WaseemALTamer/FMRadioUniversity/Dump/__Notes__.md

this contain useless files that helped me understand librries modules and so far
if you dont see code to do with other modules that  means that those modules are
simple enough to understand or have a straight forward library.
