WaseemALTamer/FMRadioUniversity/documentation/Code/design_decisions.docx

This page should not be included in the report, this is a message to the person compiling for the final report submission.

This file is decisions we made along the way when making the project, this includes decisions that did go through and ones that didn’t go through.

Design Decisions

Modular design

Before we started the project we discussed about how the project should be build and we all come to a conclusion of making each module very easily disabled, this is because we anted to make it easier for our self when modules did clash together as we added them later on this allowed us to test each module separately as we build Veroboard and PCB later on down the line, this also came in handy when measuring the time that it takes to talk over the I2C modules and how that time effects the ultrasound module as it is a time sensitive module.

Saving a GPIO pin

During the process of discussing what modules to have, we found out that we will be 1 GPIO pin short to fit all the modules that we had planned, so we started looking into which modules uses which pins and we found that the RTC clock module contain a INT pin used to tell the Arduino about the alarm, we noticed that we can leave the pin unconnected to the Arduino and since we can still communicate to the RTC clock pin through the I2C pin and ask it for the alarm time that we sad we can simply just check the alarm time internally every second and when we reach the alarm time we simply trigger the same event that the INT pin was triggering, saving this pin allowed us to add the infrared sensor.

Adding a game

After we managed to complete what we aimed for we made a simple game with our simple code architecture, the game idea is straightforward, have a right pointing arrow that you can move around the lcd which avoid the obstacles that move from right to left and the more you avoid the higher your score will be, while this game was doable we still decided against it the reason is because the SRAM was already 70% filled and filling it more was going to risk making the Arduino nano freeze due to not enough ram for the stack.

Making the event system

Before we started the project we was discussing about using interrupts or polling system, at the end of our discussion we agreed for a polling system and the reason the Arduino nano only had 2 interrupts and we wanted to add as many modules as possible, we also wanted to make the project architecture the same everywhere so we decided to build everything with polling system hooked up to an event system, and if we encounter a module that is time sensitive we can use interrupts for it which also operates on the same event system.

Pages system

After discussing what features we wanted to have in our project we noticed the features lay on 3 categories, features that control output (FM module control), features that only tell you about your surroundings like humidity or temperature, and a feature like time that only keeps track of time and displays it on the lcd, for all these features we wanted to display them on screen they all sure almost the exact same idea of being able to change them on the go for example change the volume for FM radio chip you want to change the current time, or the alarm and so on and so forth.

The problem right here was not really making the page system but rather memory management because while we can make a page for each feature that we wanted to control or display we couldn’t afford to make each page logic different from one another and where each have there own editing system because simply adding a single page it approximates about 34 bytes, and adding there own editing logic will consume another 34 bytes this adds up if you want to make 8-9 pages like we did, so we decided to go with a page for each feature and a editing logic that works on all pages this way we only end up using about 306 bytes for all the pages and another 34 bytes for the logic only which is a lot more affordable and at that time we sat at 70% memory usage after adding all the pages.

We also came to conclusion to make the page system a linked list such that each page points to the next page and the previous page, this made the navigation system a lot simple to make, this also allowed us to integrate popup pages clearly, for example the popup page for the alarm where we made popup pages appear and get linked to the page that you were last on.

LCD Scheduler system

we foresaw and problem that we could encounter where after connecting the lcd if the lcd where to be updated too fast this will cause the lcd to flicker as internally the lcd itself takes time to update the screen, we also didn’t want to update the screen when nothing on screen changed, this gave a birth the LCD scheduler system which you can update by your self rather you schedule and update to happen and the system will do it whenever it can if you try to update the lcd before it flashes itself your latest over update will be the only one that getting flashed, this helped eliminate flickering it also helped the updating the lcd not happen every update as a result other modules that are time sensitive like the ultrasound sensor had more accurate readings and over all more accurate distance measurements.

Separation of concern

Structuring our code was a big part of how we worked as a team, and before we started writing the system we laid out the structure so everybody understands it and can expand on the system while staying in line, our there is 3 different type of files, first the base layer component files which are simply the modules names, such as buttons, encoder and so on and so forth, those modules are responsible for passing the events forward to the next layer of the code, then comes the intermediate layer which consists of the whole system, which the naming goes like this “page_manager” which is responsible for handling all the different pages along with their universal edit logic, then we have the actual pages we name them as “page_*” and each page inherit the edit system, but it doesn’t inherit the apply function after editing the system so it contain the logic that it need to function as expected, for example “page_time”, is the page responsible for displaying the time and editing and setting the current time.

We also have pop up pages which follow the same exact structure as a normal page but they are not included in the linked list and when the page manager sees that they want to display themselves, the manager displays them and links them to the already displayed page at the time, this logic is also shared by all the popups assume that you have a 2 popups and somehow they both want to be displayed then the first one get linked to the page you where already on and the second one will link to the popup page itself.

The “page_*” modules don’t rely on any update logic to update them self, and they are only event driven as a result they are consistent and very predictable this also allows all the pages to stay isolated as they are never run any logic by themselves.

For quick module testing we encouraged the team to leave example files inside the example folder so we can quickly flash the Arduino and check if a specific code is written clearly and pass all the required tests before we integrate it.

We understood that many of us come from completely different backgrounds for coding ability and as result we managed to make all the project self-contain where it holds all the libraries where the specific version for them to work in the same working directory, this allows us to share the full code easily without worrying about dependency installation.

To keep track of the memory usage and which modules take more memory we encouraged the team to leave a memory usage assessment on top of the file so we can further make better decisions as our project evolves.

Code entry point

The entry point of our project marks a big step for our separation of concern for each module and the architecture layers that we build to move forward with, our entry point is the place that lets us disable or enable modules on the go by simply commenting the initiation of each module and also disabling the polling loop for each module, and because the page system simply runs over the events, the pages will still be there but the content will be missing, this also worked to our advantage to quickly assess which modules are working correctly and which modules are not working properly.
