WaseemALTamer/FMRadioUniversity/PCB/Version-1/footprints/TDA2822D/TDA2822D.step

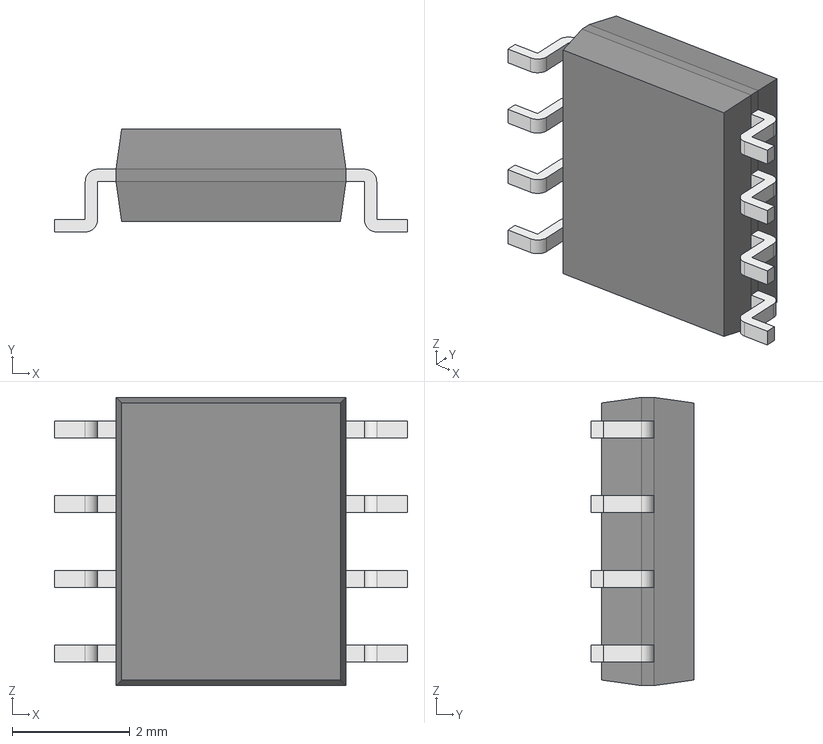
[picture p18: CAD file, 2026-08-18, an earlier design]
PCB/Version-1/footprints/TDA2822D/TDA2822D.step
6.00 x 1.75 x 4.90 mm
Body001 (Mirror #1) x 4
XY-plane x 12
X-axis x 12
