WaseemALTamer/FMRadioUniversity/PCB/Version-2/FMRadio.kicad_pcb

## KiCad design PCB/Version-2/FMRadio.kicad_pcb (2026-08-18)

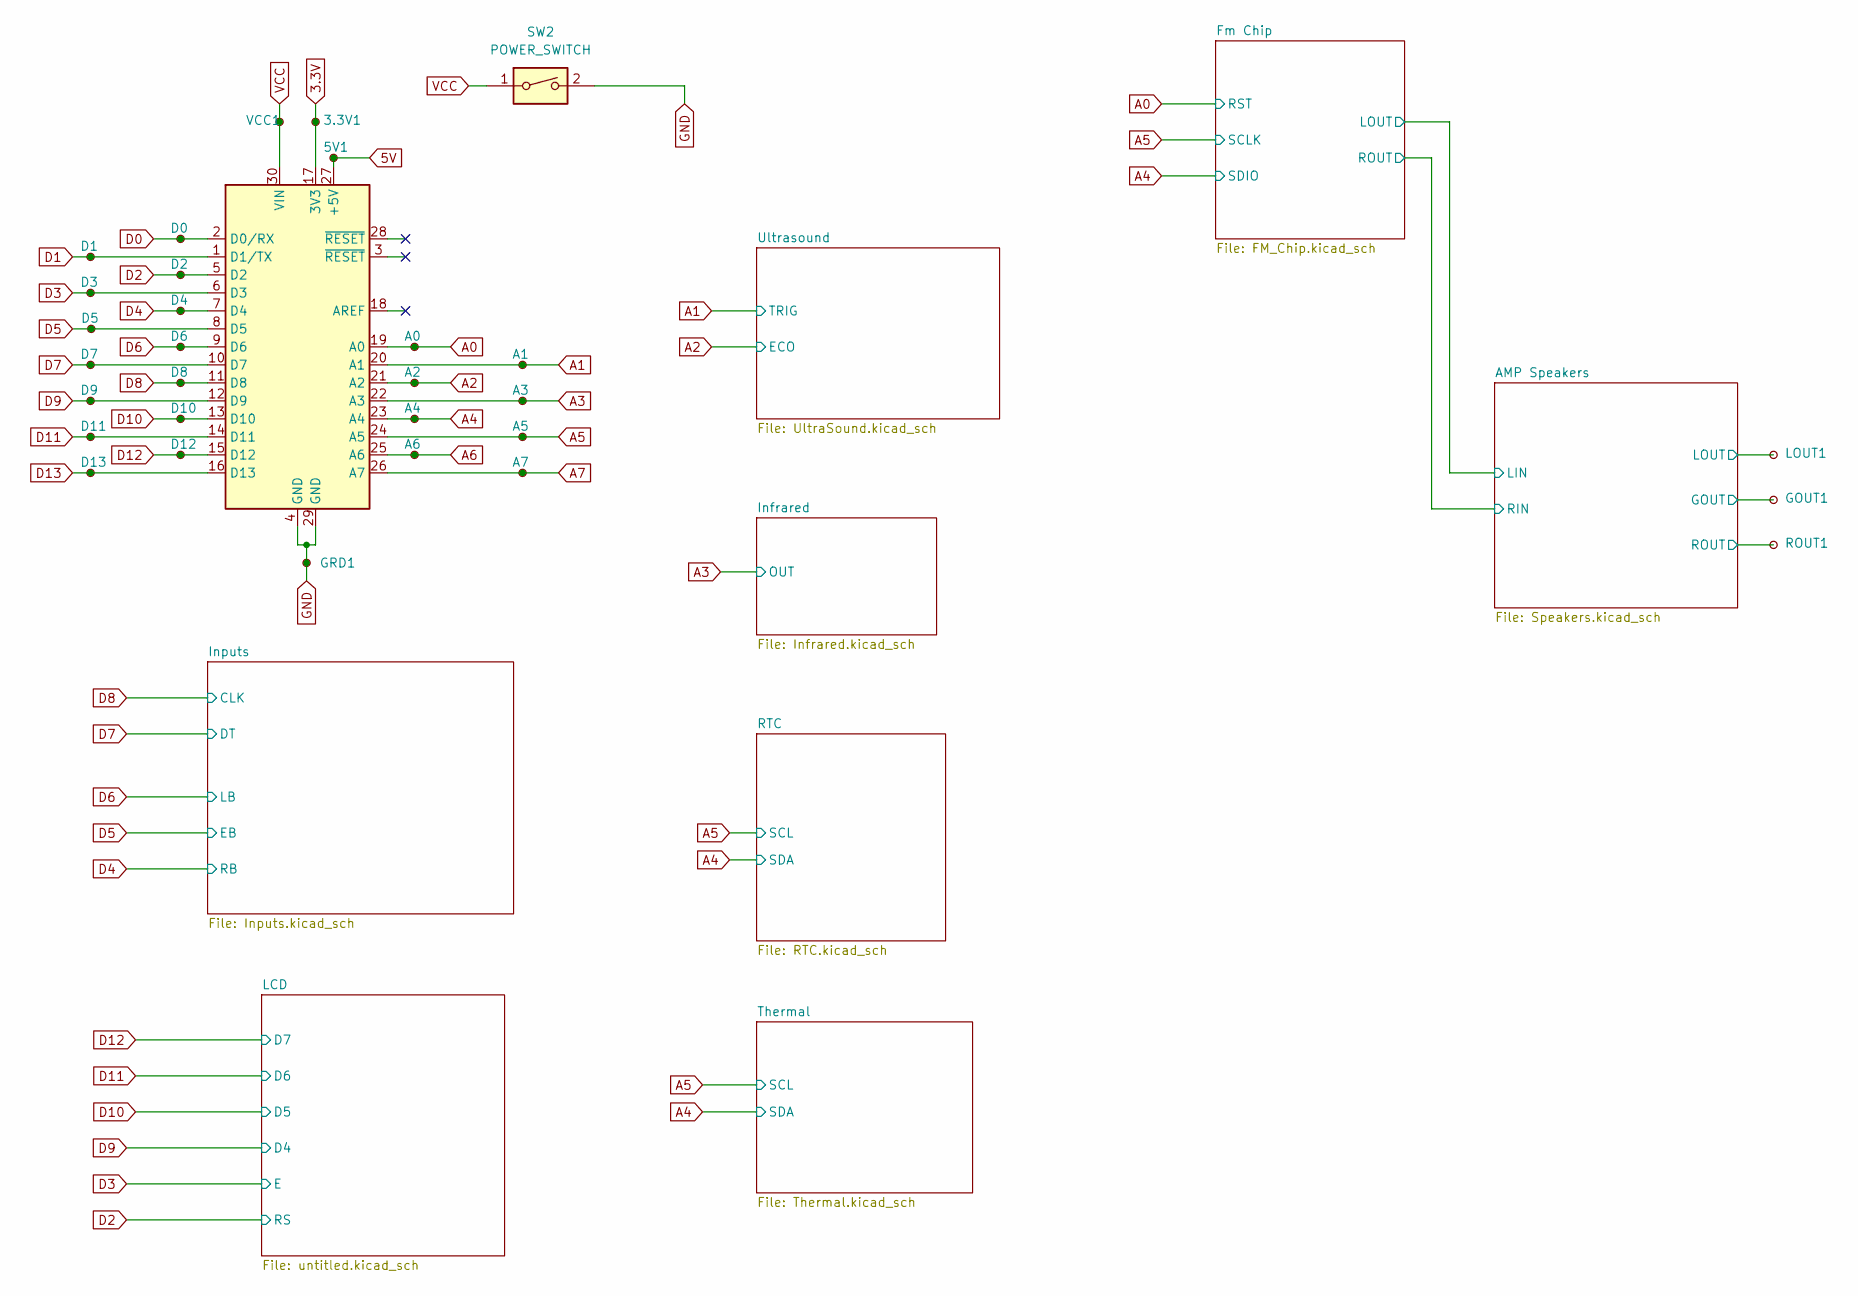
[picture p19: schematic FMRadio.kicad_sch]

Parts:
3.3V1, 5V1: TestPoint_Small; PinHeader_1x04_P2.54mm_Vertical_Custum_shortedpins
A0, A1, A2, A3, A4, A5, A6, A7: TestPoint_Small; PinHeader_1x04_P2.54mm_Vertical_Custum_shortedpins
AN1: Arduino_Nano_v3.x; Arduino_Nano
D0, D1, D2, D3, D4, D5, D6, D7, D8, D9, D10, D11, D12, D13: TestPoint_Small; PinHeader_1x04_P2.54mm_Vertical_Custum_shortedpins
GOUT1: PinHeader_1x04_P2.54mm_Vertical_Custum_shortedpins
GRD1: TestPoint_Small; PinHeader_1x04_P2.54mm_Vertical_Custum_shortedpins
LOUT1: PinHeader_1x04_P2.54mm_Vertical_Custum_shortedpins
ROUT1: PinHeader_1x04_P2.54mm_Vertical_Custum_shortedpins
SW2: POWER_SWITCH; PinHeader_1x02_P2.54mm_Vertical
VCC1: TestPoint_Small; PinHeader_1x04_P2.54mm_Vertical_Custum_shortedpins

Connections:
3.3V: 3.3V1.1, AN1.17 (3V3); also elsewhere on the board
5V: 5V1.1, AN1.27 (+5V); also elsewhere on the board
/AMP Speakers/LOUT: LOUT1.1; also elsewhere on the board
/AMP Speakers/ROUT: ROUT1.1; also elsewhere on the board
A0: A0.1, AN1.19 (A0); also elsewhere on the board
A1: A1.1, AN1.20 (A1); also elsewhere on the board
A2: A2.1, AN1.21 (A2); also elsewhere on the board
A3: A3.1, AN1.22 (A3); also elsewhere on the board
A4: A4.1, AN1.23 (A4); also elsewhere on the board
A5: A5.1, AN1.24 (A5); also elsewhere on the board
A6: A6.1, AN1.25 (A6)
A7: A7.1, AN1.26 (A7)
D0: AN1.2 (D0/RX), D0.1
D1: AN1.1 (D1/TX), D1.1
D2: AN1.5 (D2), D2.1; also elsewhere on the board
D3: AN1.6 (D3), D3.1; also elsewhere on the board
D4: AN1.7 (D4), D4.1; also elsewhere on the board
D5: AN1.8 (D5), D5.1; also elsewhere on the board
D6: AN1.9 (D6), D6.1; also elsewhere on the board
D7: AN1.10 (D7), D7.1; also elsewhere on the board
D8: AN1.11 (D8), D8.1; also elsewhere on the board
D9: AN1.12 (D9), D9.1; also elsewhere on the board
D10: AN1.13 (D10), D10.1; also elsewhere on the board
D11: AN1.14 (D11), D11.1; also elsewhere on the board
D12: AN1.15 (D12), D12.1; also elsewhere on the board
D13: AN1.16 (D13), D13.1
GND: AN1.4 (GND), AN1.29 (GND), GOUT1.1, GRD1.1, SW2.2; also elsewhere on the board
VCC: AN1.30 (VIN), SW2.1, VCC1.1; also elsewhere on the board

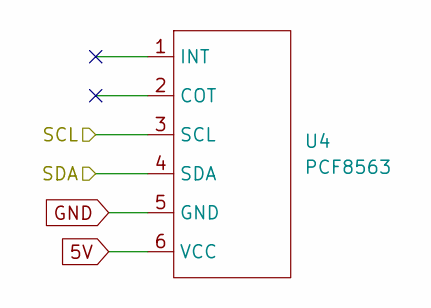
[picture p20: schematic RTC.kicad_sch]

Parts:
U4: PCF8563; PinHeader_1x06_P2.54mm_Vertical

Connections:
5V: U4.6 (VCC); also elsewhere on the board
A4: U4.4 (SDA); also elsewhere on the board
A5: U4.3 (SCL); also elsewhere on the board
GND: U4.5 (GND); also elsewhere on the board

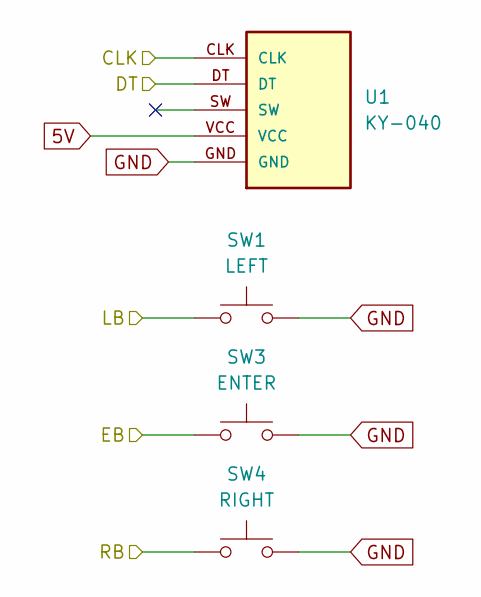
[picture p21: schematic Inputs.kicad_sch]

Parts:
SW1: LEFT; SW_PUSH_6mm_H4.3mm
SW3: ENTER; SW_PUSH_6mm_H4.3mm
SW4: RIGHT; SW_PUSH_6mm_H4.3mm
U1: KY-040; KY-040-PORT

Connections:
5V: U1.VCC; also elsewhere on the board
D4: SW4.1; also elsewhere on the board
D5: SW3.1; also elsewhere on the board
D6: SW1.1; also elsewhere on the board
D7: U1.DT; also elsewhere on the board
D8: U1.CLK; also elsewhere on the board
GND: SW1.2, SW3.2, SW4.2, U1.GND; also elsewhere on the board

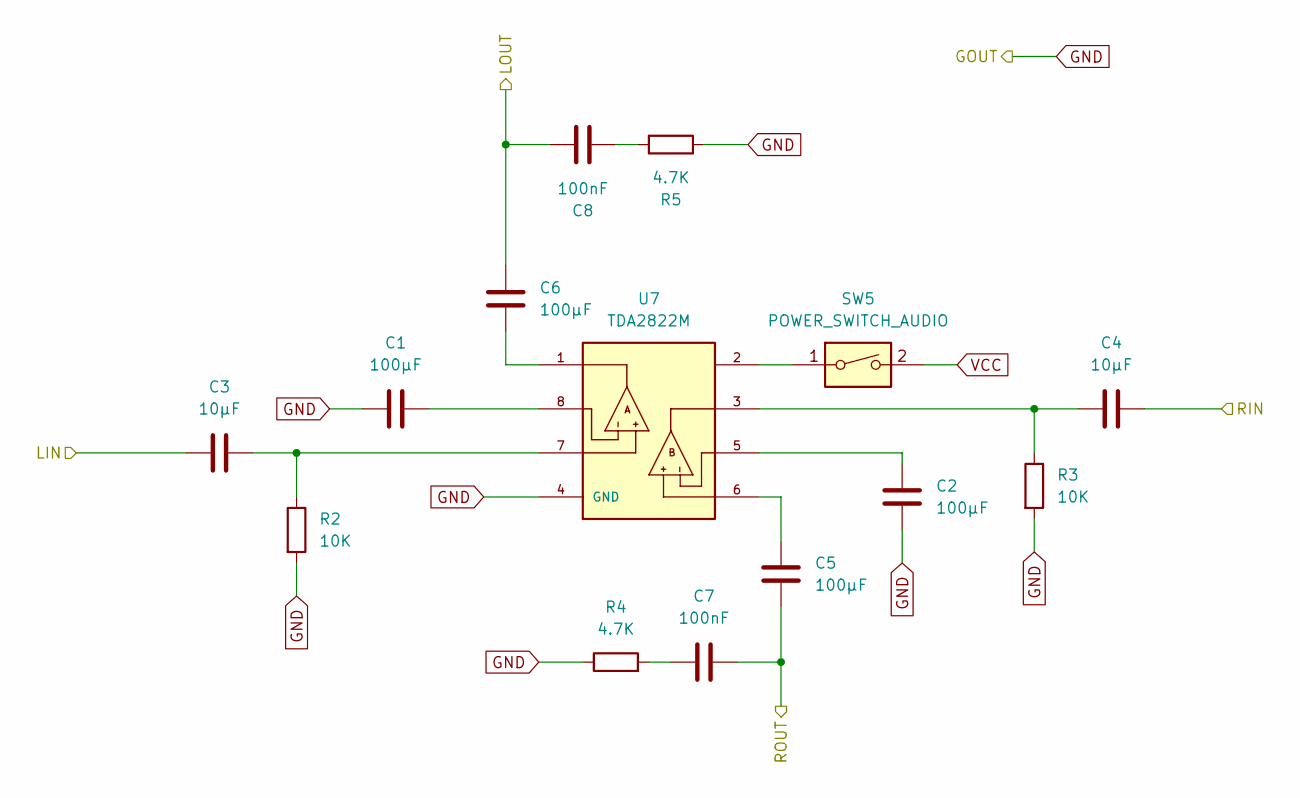
[picture p22: schematic Speakers.kicad_sch]

Parts:
C1, C2, C5, C6: 100μF; CP_Radial_D5.0mm_P2.50mm
C3, C4: 10μF; CP_Radial_D5.0mm_P2.50mm
C7, C8: 100nF; CP_Radial_D5.0mm_P2.50mm
R2, R3: 10K; R_Axial_DIN0207_L6.3mm_D2.5mm_P10.16mm_Horizontal
R4, R5: 4.7K; R_Axial_DIN0207_L6.3mm_D2.5mm_P10.16mm_Horizontal
SW5: POWER_SWITCH_AUDIO; PinHeader_1x02_P2.54mm_Vertical
U7: TDA2822M; DIP762W45P254L1092H508Q8; PARTREV September 2003

Connections:
/AMP Speakers/LIN: C3.1; also elsewhere on the board
/AMP Speakers/LOUT: C6.2, C8.1; also elsewhere on the board
/AMP Speakers/RIN: C4.2; also elsewhere on the board
/AMP Speakers/ROUT: C5.1, C7.1; also elsewhere on the board
GND: C1.1, C2.1, R2.2, R3.2, R4.1, R5.1, U7.4 (GND); also elsewhere on the board
unnamed: C1.2, U7.8
unnamed: C2.2, U7.5
unnamed: C3.2, R2.1, U7.7
unnamed: C4.1, R3.1, U7.3
unnamed: C5.2, U7.6
unnamed: C6.1, U7.1
unnamed: C7.2, R4.2
unnamed: C8.2, R5.2
unnamed: SW5.1, U7.2
VCC: SW5.2; also elsewhere on the board

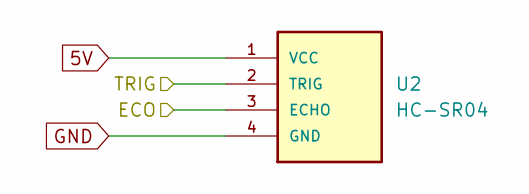
[picture p23: schematic UltraSound.kicad_sch]

Parts:
U2: HC-SR04; XCVR_HC-SR04

Connections:
5V: U2.1 (VCC); also elsewhere on the board
A1: U2.2 (TRIG); also elsewhere on the board
A2: U2.3 (ECHO); also elsewhere on the board
GND: U2.4 (GND); also elsewhere on the board

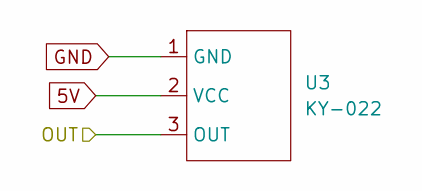
[picture p24: schematic Infrared.kicad_sch]

Parts:
U3: KY-022; PinHeader_1x03_P2.54mm_Vertical

Connections:
5V: U3.2 (VCC); also elsewhere on the board
A3: U3.3 (OUT); also elsewhere on the board
GND: U3.1 (GND); also elsewhere on the board

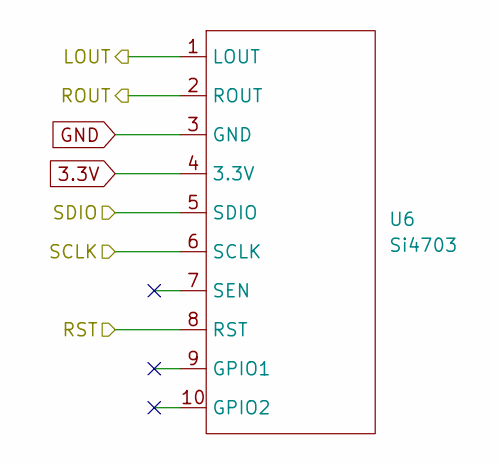
[picture p25: schematic FM_Chip.kicad_sch]

Parts:
U6: Si4703; PinHeader_1x10_P2.54mm_Vertical

Connections:
3.3V: U6.4 (3.3V); also elsewhere on the board
/AMP Speakers/LIN: U6.1 (LOUT); also elsewhere on the board
/AMP Speakers/RIN: U6.2 (ROUT); also elsewhere on the board
A0: U6.8 (RST); also elsewhere on the board
A4: U6.5 (SDIO); also elsewhere on the board
A5: U6.6 (SCLK); also elsewhere on the board
GND: U6.3 (GND); also elsewhere on the board

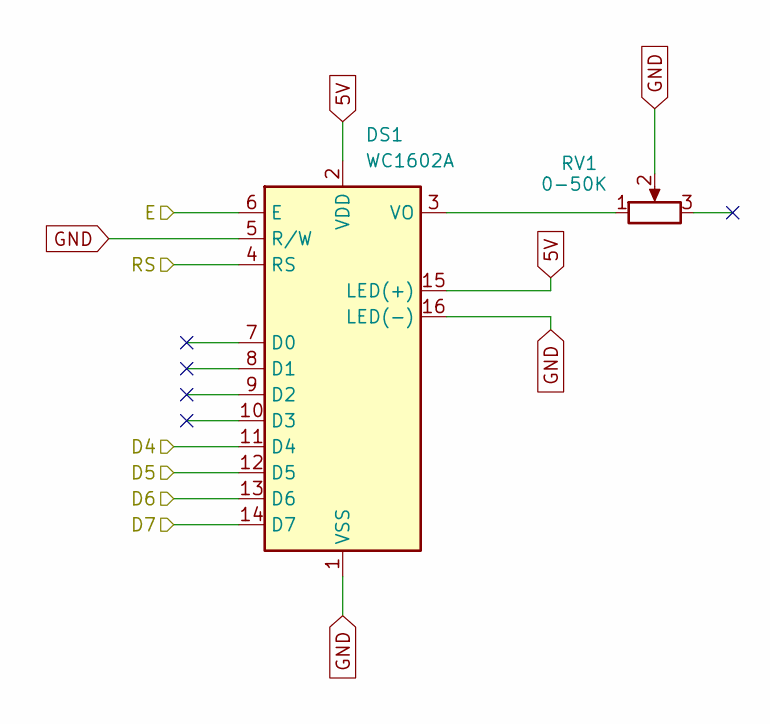
[picture p26: schematic untitled.kicad_sch]

Parts:
DS1: WC1602A
RV1: 0-50K; Potentiometer_Piher_PT-10-V10_Vertical

Connections:
5V: DS1.2 (VDD), DS1.15 (LED(+)); also elsewhere on the board
D2: DS1.4 (RS); also elsewhere on the board
D3: DS1.6 (E); also elsewhere on the board
D9: DS1.11 (D4); also elsewhere on the board
D10: DS1.12 (D5); also elsewhere on the board
D11: DS1.13 (D6); also elsewhere on the board
D12: DS1.14 (D7); also elsewhere on the board
GND: DS1.1 (VSS), DS1.5 (R/W), DS1.16 (LED(-)), RV1.2; also elsewhere on the board
unnamed: DS1.3 (VO), RV1.1

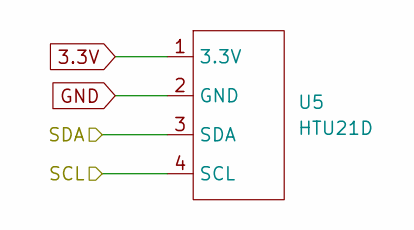
[picture p27: schematic Thermal.kicad_sch]

Parts:
U5: HTU21D; PinHeader_1x04_P2.54mm_Vertical

Connections:
3.3V: U5.1 (3.3V); also elsewhere on the board
A4: U5.3 (SDA); also elsewhere on the board
A5: U5.4 (SCL); also elsewhere on the board
GND: U5.2 (GND); also elsewhere on the board

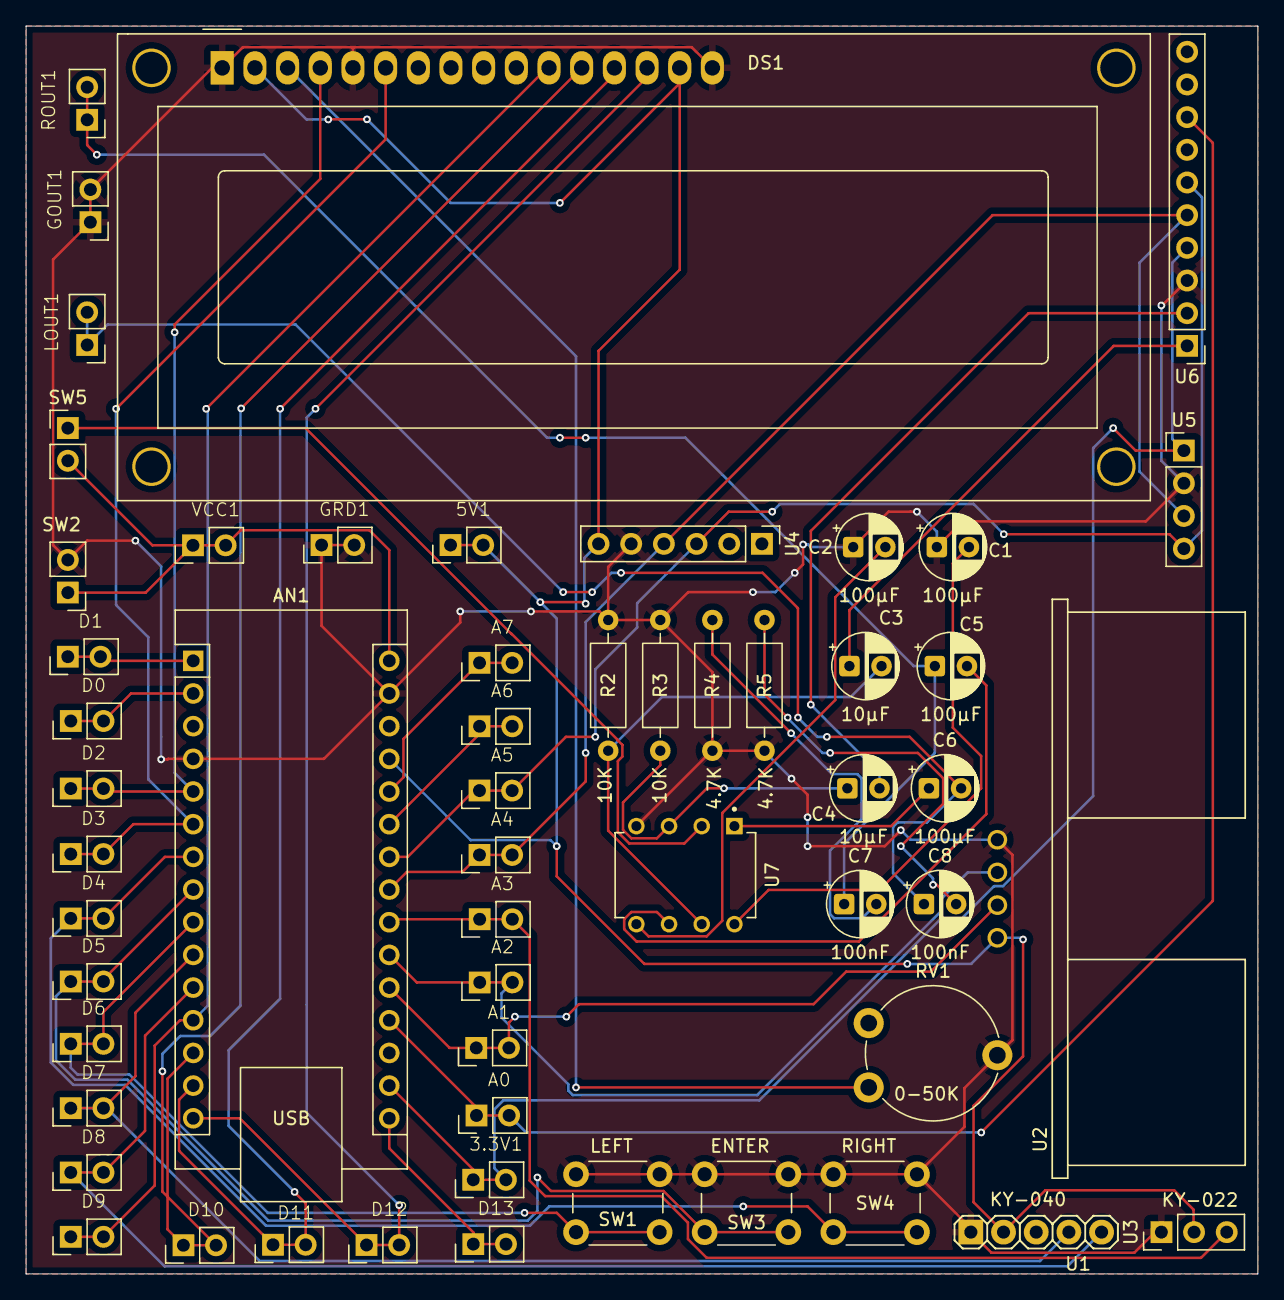
[picture p28: board FMRadio.kicad_pcb from above]

Board: 2 copper layers, 95.8 x 97.0 mm, 56 parts (0 on the bottom side), 40 nets.
