WaseemALTamer/FMRadioUniversity/PCB/Version-1/Fm_radio.kicad_pcb

## KiCad design PCB/Version-1/Fm_radio.kicad_pcb (2026-08-18, an earlier design)

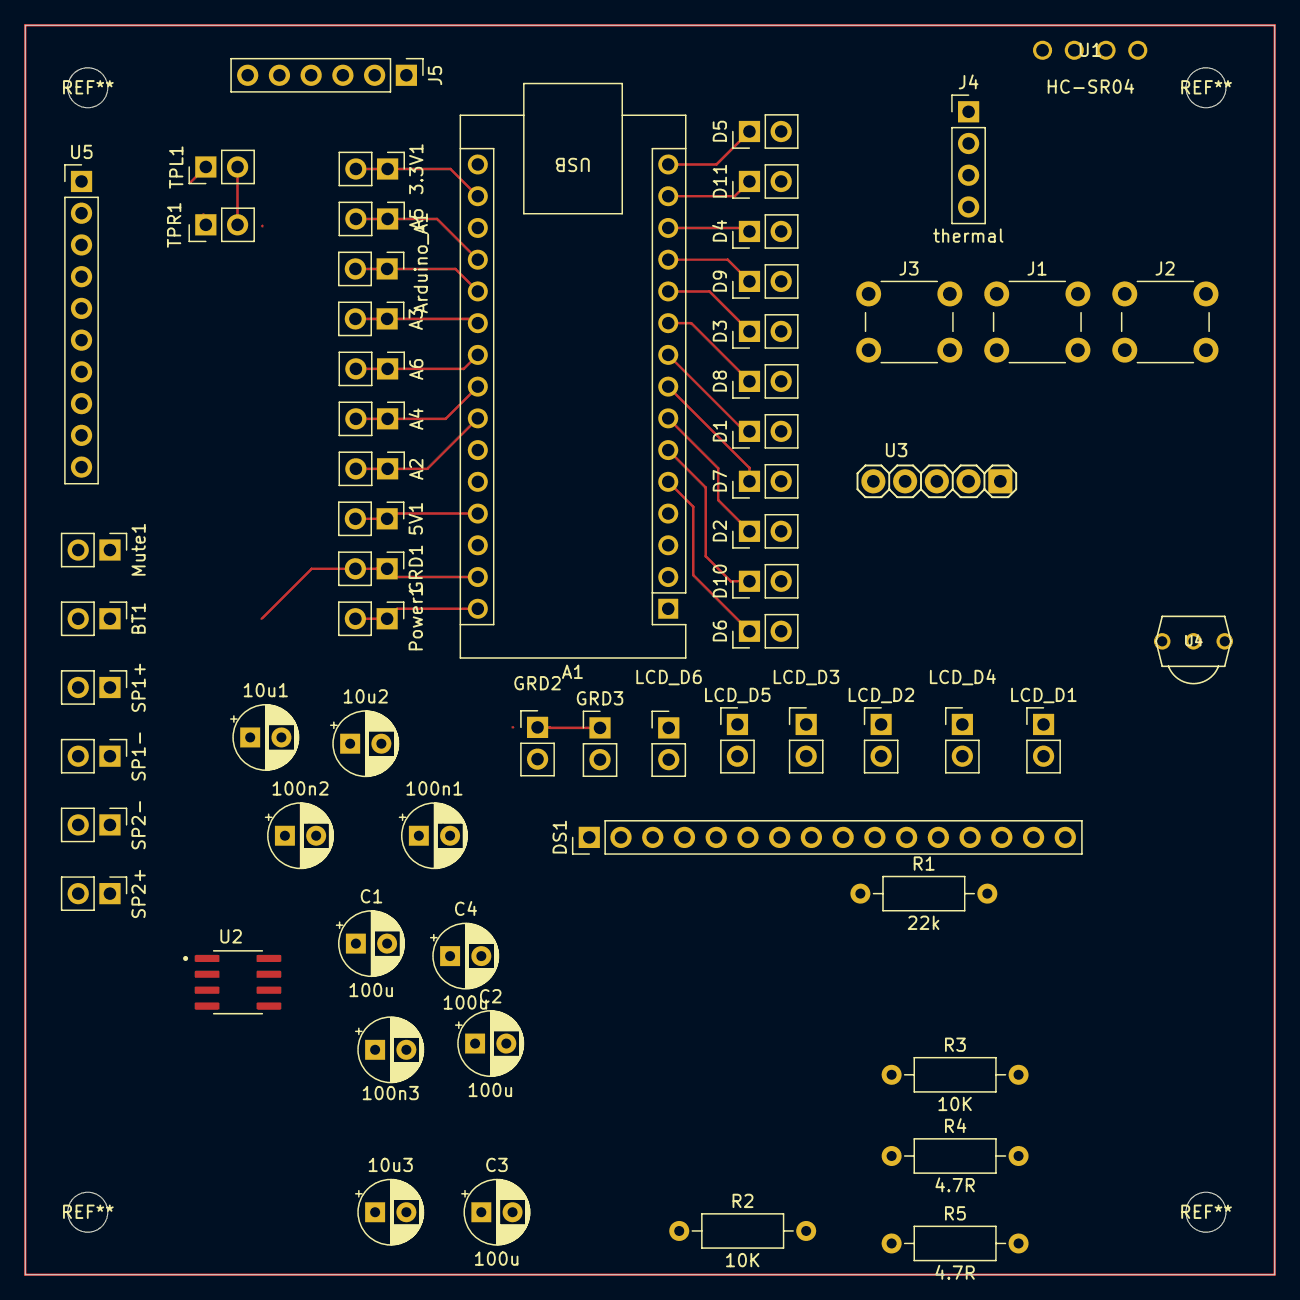
[picture p29: board Fm_radio.kicad_pcb from above]

Board: 2 copper layers, 100.0 x 100.0 mm, 64 parts (0 on the bottom side), 36 nets.

Parts:
3.3V1: 3.3V; PinHeader_1x02_P2.54mm_Vertical
5V1: D2; PinHeader_1x02_P2.54mm_Vertical
10u1, 10u2, 10u3: C_Polarized; CP_Radial_D5.0mm_P2.50mm
100n1, 100n2, 100n3: C; CP_Radial_D5.0mm_P2.50mm
A1: Arduino_Nano_v3.x; Arduino_Nano
A2: A5; PinHeader_1x02_P2.54mm_Vertical
A3: A2; PinHeader_1x02_P2.54mm_Vertical
A4: A4; PinHeader_1x02_P2.54mm_Vertical
A5: A0; PinHeader_1x02_P2.54mm_Vertical
A6: A3; PinHeader_1x02_P2.54mm_Vertical
Arduino_A1: A1; PinHeader_1x02_P2.54mm_Vertical
BT1: Battery; PinHeader_1x02_P2.54mm_Vertical
C1, C2, C3, C4: 100u; CP_Radial_D5.0mm_P2.50mm
D1: D6; PinHeader_1x02_P2.54mm_Vertical
D2: D4; PinHeader_1x02_P2.54mm_Vertical
D3: D8; PinHeader_1x02_P2.54mm_Vertical
D4: D10; PinHeader_1x02_P2.54mm_Vertical
D5: D12; PinHeader_1x02_P2.54mm_Vertical
D6: D2; PinHeader_1x02_P2.54mm_Vertical
D7: D5; PinHeader_1x02_P2.54mm_Vertical
D8: D7; PinHeader_1x02_P2.54mm_Vertical
D9: D9; PinHeader_1x02_P2.54mm_Vertical
D10: D3; PinHeader_1x02_P2.54mm_Vertical
D11: D11; PinHeader_1x02_P2.54mm_Vertical
DS1: WC1602A; PinHeader_1x16_P2.54mm_Vertical
GRD1, GRD2, GRD3: GRD; PinHeader_1x02_P2.54mm_Vertical
J1: Button _enter; SW_PUSH_6mm
J2: Button _right; SW_PUSH_6mm
J3: Button _left; SW_PUSH_6mm
J4: thermal; PinHeader_1x04_P2.54mm_Vertical
J5: RTC; PinHeader_1x06_P2.54mm_Vertical
LCD_D1: D12; PinHeader_1x02_P2.54mm_Vertical
LCD_D2: D10; PinHeader_1x02_P2.54mm_Vertical
LCD_D3: D9; PinHeader_1x02_P2.54mm_Vertical
LCD_D4: D11; PinHeader_1x02_P2.54mm_Vertical
LCD_D5: D2; PinHeader_1x02_P2.54mm_Vertical
LCD_D6: D3; PinHeader_1x02_P2.54mm_Vertical
Mute1: TestPoint_2Pole; PinHeader_1x02_P2.54mm_Vertical
Power1: TestPoint_2Pole; PinHeader_1x02_P2.54mm_Vertical
R1: 22k; R_Axial_DIN0207_L6.3mm_D2.5mm_P10.16mm_Horizontal
R2, R3: 10K; R_Axial_DIN0207_L6.3mm_D2.5mm_P10.16mm_Horizontal
R4, R5: 4.7R; R_Axial_DIN0207_L6.3mm_D2.5mm_P10.16mm_Horizontal
SP1+, SP2+: +V OUT; PinHeader_1x02_P2.54mm_Vertical
SP1-, SP2-: -V OUT; PinHeader_1x02_P2.54mm_Vertical
TPL1: Left in; PinHeader_1x02_P2.54mm_Vertical
TPR1: Right in; PinHeader_1x02_P2.54mm_Vertical
U1: HC-SR04; XCVR_HC-SR04
U2: TDA2822D
U3: KY-040; KY-040-PORT
U4: TSOP1838; TSOP18XX
U5: PinHeader_1x10_P2.54mm_Vertical

Connections:
3.3V: 3.3V1.1, A1.17 (3V3), J4.1, U5.4 (VCC)
5V: 5V1.1, A1.27 (+5V), DS1.2 (VDD), DS1.15 (LED(+)), Mute1.1, U1.1 (VCC), U3.VCC, U4.VCC (V+)
/AMP Speakers/5V: 10u3.1, 100n1.1, Mute1.2, U2.2
/AMP Speakers/L_Speaker_in: 100n2.1, C3.2, SP1+.1
/AMP Speakers/L_out: 10u2.1, TPL1.1, U5.1 (L_out)
/AMP Speakers/R_Speaker_in: 100n3.1, C4.2, SP2+.1
/AMP Speakers/R_out: 10u1.1, TPR1.1, U5.2 (R_out)
A0: A1.19 (A0), A5.1, U5.8 (RST)
A1: A1.20 (A1), Arduino_A1.1, U1.2 (TRIG)
A2: A1.21 (A2), A3.1, U1.3 (ECHO)
A3: A1.22 (A3), A6.1, J5.6, U4.OUT
A4: A1.23 (A4), A4.1, J4.4, J5.3, U5.5 (SDIO)
A5: A1.24 (A5), A2.1, J4.3, J5.4, U5.6 (SCLK)
D2: A1.5 (D2), D6.1, DS1.6 (E), LCD_D5.1
D3: A1.6 (D3), D10.1, DS1.4 (RS), LCD_D6.1
D4: A1.7 (D4), D2.1, J1.2
D5: A1.8 (D5), D7.1, J2.2
D6: A1.9 (D6), D1.1, J3.2
D7: A1.10 (D7), D8.1, U3.DT
D8: A1.11 (D8), D3.1, U3.CLK
D9: A1.12 (D9), D9.1, DS1.11 (D4), LCD_D3.1
D10: A1.13 (D10), D4.1, DS1.12 (D5), LCD_D2.1
D11: A1.14 (D11), D11.1, DS1.13 (D6), LCD_D4.1
D12: A1.15 (D12), D5.1, DS1.14 (D7), LCD_D1.1
GRD: 10u3.2, 100n1.2, A1.4 (GND), A1.29 (GND), BT1.2 (-), C1.2, C2.2, DS1.1 (VSS), DS1.5 (R/W), DS1.16 (LED(-)), GRD1.1, GRD2.1, GRD3.1, J1.1, J2.1, J3.1, J4.2, J5.2, R1.2, R2.2, R3.2, R4.2, R5.2, SP1-.1, SP2-.1, U1.4 (GND), U2.4, U3.GND, U4.GND, U5.3 (GND)
unnamed: 10u1.2, R2.1, U2.7
unnamed: 10u2.2, R3.1, U2.6
unnamed: 100n2.2, R4.1
unnamed: 100n3.2, R5.1
unnamed: BT1.1 (+), Power1.2
unnamed: C1.1, U2.8
unnamed: C2.1, U2.5
unnamed: C3.1, U2.1
unnamed: C4.1, U2.3
unnamed: DS1.3 (VO), R1.1
VCC: A1.30 (VIN), Power1.1
